nycresistor/TotU/README.md

TotU
====

Temple of the Unticketed

TotU
