nycresistor/TotU/Design/totu-sketch.png

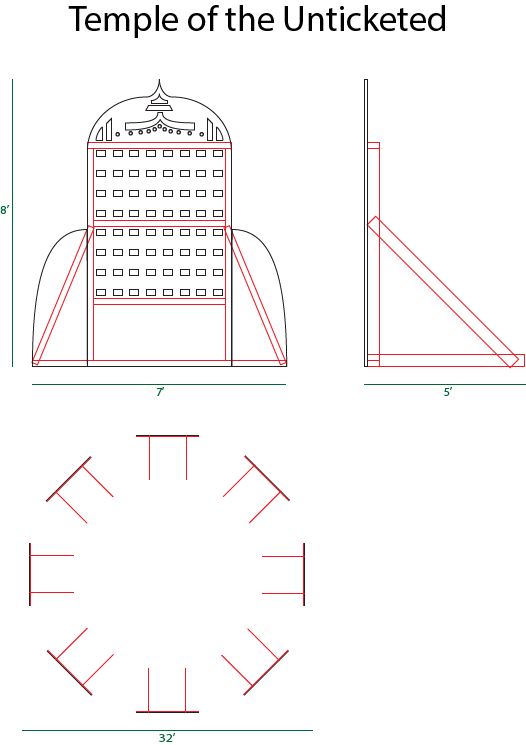
Design/totu-sketch.png
