nycresistor/TotU/Processing/TotU/data/0-PhotoBoothPhotoSmall.jpg

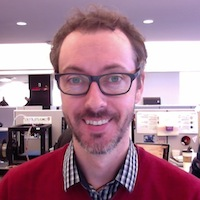
Processing/TotU/data/0-PhotoBoothPhotoSmall.jpg
