nycresistor/TotU/Processing/TotU/data/BMan11.jpg

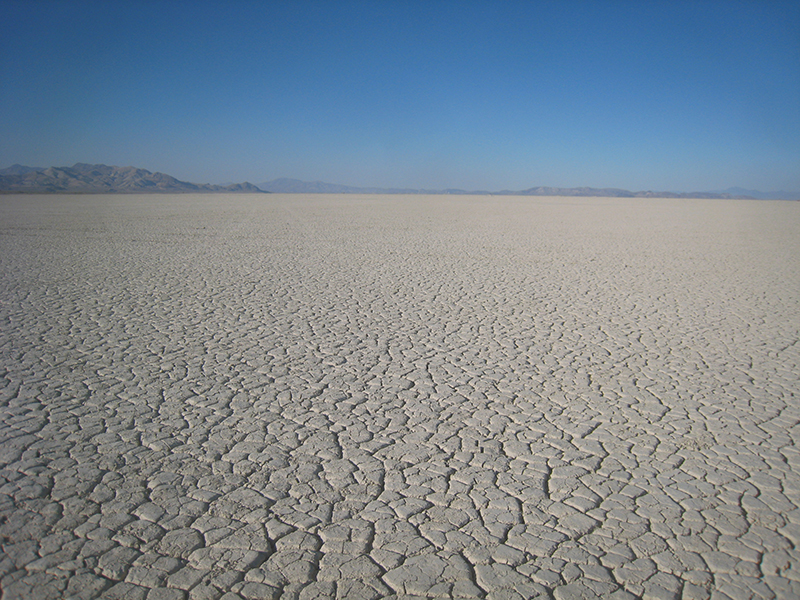
Processing/TotU/data/BMan11.jpg
