nycresistor/TotU/Logistics/TotU Budget.xlsx

Sheet: Budget
Temple of the Unticketed - Planning Budget
 |  |  | Tier 1 |  |  |  | Tier 2 |  |  |  | Tier 3
Line Item | Unit Cost | Redunancy | Per Panel | # Panels | Total | Cost | Per Panel | # Panels | Total | Cost | Per Panel | # Panels | Total | Cost
Cape
BBB | $55.00 | 50% | 4 | 8 | 48 | $2,640.00 | 2 | 8 | 24 | $1,320.00 | 2 | 6 | 18 | $990.00
Screens | $6.97 | 20% | 64 | 8 | 615 | $4,286.55 | 32 | 8 | 308 | $2,146.76 | 32 | 6 | 231 | $1,610.07
PCB (OSH Park) | $33.33 | 50% | 4 | 8 | 48 | $1,599.84 | 2 | 8 | 24 | $799.92 | 2 | 6 | 18 | $599.94
Assembly (Screaming) | $23.69 | 0% | 0 | 8 | 0 | $0.00 | 0 | 8 | 0 | $0.00 | 0 | 6 | 0 | $0.00
Components | $30.00 | 20% | 4 | 8 | 39 | $1,170.00 | 2 | 8 | 20 | $600.00 | 2 | 6 | 15 | $450.00
 |  |  |  |  |  |  |  |  | 0 |  |  |  | 0
TFT Adapter |  |  |  |  |  |  |  |  | 0 |  |  |  | 0
PCB (Sunstone) | $1.35 | 20% | 64 | 8 | 615 | $830.25 | 32 | 8 | 308 | $415.80 | 32 | 6 | 231 | $311.85
Assembly (Screaming) | $2.17 | 0% | 0 | 8 | 0 | $0.00 | 0 | 8 | 0 | $0.00 | 0 | 6 | 0 | $0.00
Components | $1.60 | 20% | 64 | 8 | 615 | $984.00 | 32 | 8 | 308 | $492.80 | 32 | 6 | 231 | $369.60
Power Module
PCB | $33.33 | 20% | 1 | 8 | 10 | $333.30 | 1 | 8 | 10 | $333.30 | 1 | 6 | 8 | $266.64
Assembly | $20.00 | 0% | 0 | 8 | 0 | $0.00 | 0 | 8 | 0 | $0.00 | 0 | 6 | 0 | $0.00
Components | $8.20 | 20% | 1 | 8 | 10 | $82.00 | 1 | 8 | 10 | $82.00 | 1 | 6 | 8 | $65.60
Networking
Switch | $100.00 | 20% | 1 | 8 | 10 | $1,000.00 | 1 | 8 | 10 | $1,000.00 | 1 | 6 | 8 | $800.00
BBB Master | $55.00 | 20% | 1 | 8 | 10 | $550.00 | 1 | 8 | 10 | $550.00 | 1 | 6 | 8 | $440.00
Cabling
25FT RJ45 | $11.28 | 5% | 2 | 8 | 17 | $191.76 | 2 | 8 | 17 | $191.76 | 2 | 6 | 13 | $146.64
2FT RJ45 | $0.75 | 5% | 64 | 8 | 538 | $403.50 | 32 | 8 | 269 | $201.75 | 32 | 6 | 202 | $151.50
Power
Batteries | $100.00 | 10% | 2 | 8 | 18 | $1,800.00 | 2 | 8 | 18 | $1,800.00 | 2 | 6 | 14 | $1,400.00
Chargers | $50.00 | 10% | 1 | 8 | 9 | $450.00 | 1 | 8 | 9 | $450.00 | 1 | 6 | 7 | $350.00
Hardware
Screws, etc. | $10.00 | 0% | 1 | 8 | 8 | $80.00 | 1 | 8 | 8 | $80.00 | 1 | 6 | 6 | $60.00
Wood | $20.00 | 0% | 1 | 8 | 8 | $160.00 | 1 | 8 | 8 | $160.00 | 1 | 6 | 6 | $120.00
Rebar, Sandbags | $20.00 | 0% | 1 | 8 | 8 | $160.00 | 1 | 8 | 8 | $160.00 | 1 | 6 | 6 | $120.00
Steel Pipe | $50.00 | 10% | 1 | 8 | 9 | $450.00 | 1 | 8 | 9 | $450.00 | 1 | 6 | 7 | $350.00
Fixed Costs |  |  |  |  |  | $17,171.20 |  |  |  | $11,234.09 |  |  |  | $8,601.84
Connectivity | $200.00
WiFi Equipment | $500.00
Gas/Electricity | $150.00
Container Space | $750.00
 | $1,600.00 |  |  |  | Total Tier 1 | $18,771.20 |  |  | Total Tier 2 | $12,834.09 |  |  | Total Tier 3 | $10,201.84

Sheet: Container Space
Assumptions | Panels |  |  | Base
Stackable panels | Width | 4 |  | Width | 10 | 2 x 10' pipes per base
Bases are stored as pipes+plywood | Height | 8 |  | Height | 4
 | Depth | 1 |  | Depth | 0.83
 |  | 32 |  |  | 33.2
 |  | 65.2 | cu ft
 |  | $489.00 | total
 |  | $733.50 | overbudget
