nycresistor/TotU/Design/lens.stl

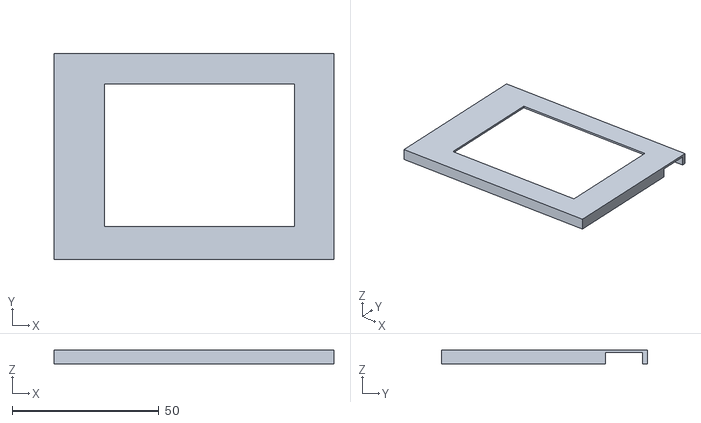
[picture p7: CAD file, 2015-05-30]
Design/lens.stl
95.5 x 70.2 x 4.80
