nycresistor/TotU/(threads)

Thread 6 (2014-12-31):

Mosfets are slightly too small to solder comfortably by hand

mhenstell, 2014-12-31:

Closed 2015-01-02.

Thread 11 (2015-01-03):

Mosfet symbol might have pins swapped

mhenstell, 2015-01-03:

Closed 2015-01-18.

Thread 18 (2015-02-03):

Fix or find better camera controls

potatono, 2015-02-03:

Thread 23 (2015-02-15):

Add caps to power/DC/reset lines on cape just for funsies

mhenstell, 2015-02-15:

Thread 24 (2015-02-15):

Replace power input connector with DC-DC board

mhenstell, 2015-02-15:

Thread 28 (2015-02-16):

TFT 0 backlight (pwm_0, gpio0_7) not working right

mhenstell, 2015-02-16:

mhenstell, 2015-02-17:
B 6th column off
A 1st col bottom out of phase??

mhenstell, 2015-02-18:
B6 seems to be an electrical issue, replace the mosfet and test again.
