nycresistor/TotU/Design/TotU.pdf

# Temple of the Unticketed

## Design Planning

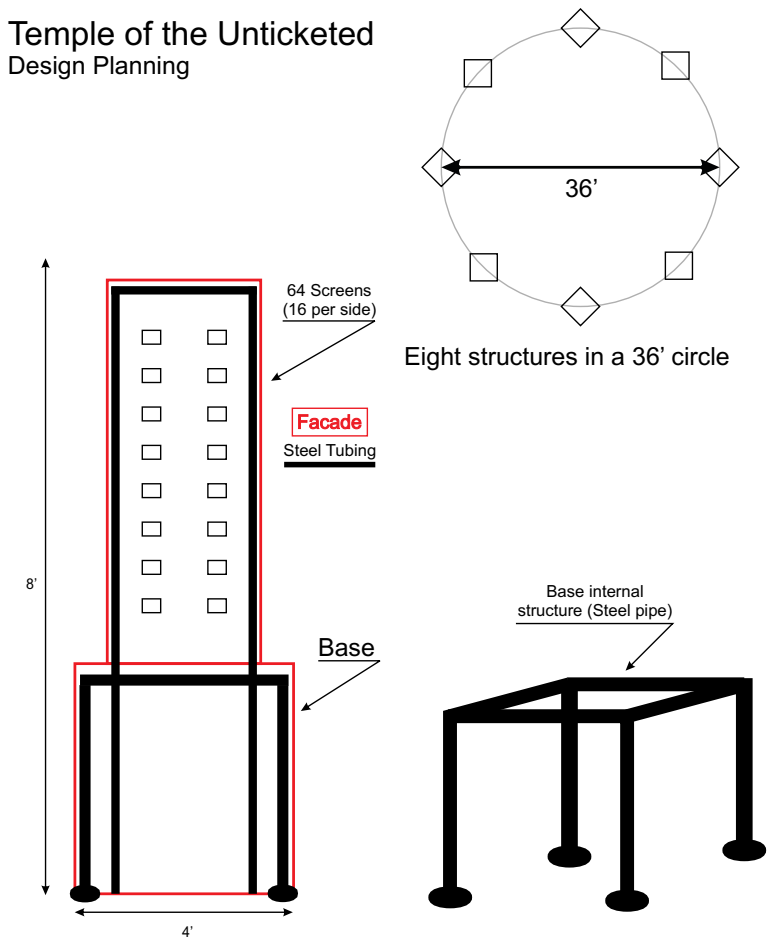
[picture p8: page 1]
Base; 64 Screens (16 per side); Facade; Steel Tubing

Eight structures in a 36’ circle

Base internal
structure (Steel pipe)
