nycresistor/TotU/Hardware/tft.brd

## EAGLE design Hardware/tft.brd (2015-01-20)

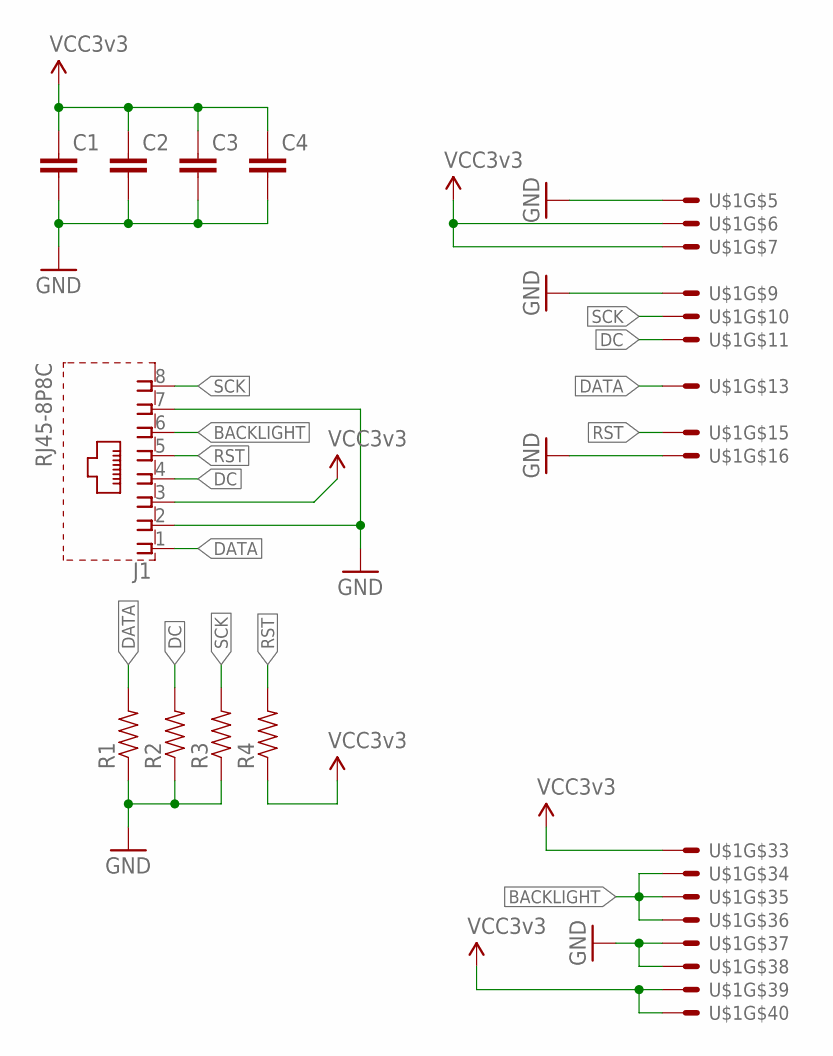
[picture p13: schematic tft.sch]

Parts:
C1, C2, C3, C4: CAP1206; 1206
J1: RJ45-8P8C; 54602-908LF; PARTNO 54602-908LF
R1, R2, R3, R4: RESISTOR0603; 0603-RES
U$1: XF2M-4015-WONKY

Connections:
BACKLIGHT: J1.6, U$1.34, U$1.35, U$1.36
DATA: J1.1, R1.2, U$1.13
DC: J1.4, R2.2, U$1.11
GND: C1.2, C2.2, C3.2, C4.2, J1.2, J1.7, R1.1, R2.1, R3.1, U$1.5, U$1.9, U$1.16, U$1.37, U$1.38
RST: J1.5, R4.2, U$1.15
SCK: J1.8, R3.2, U$1.10
VCC3V3: C1.1, C2.1, C3.1, C4.1, J1.3, R4.1, U$1.6, U$1.7, U$1.33, U$1.39, U$1.40

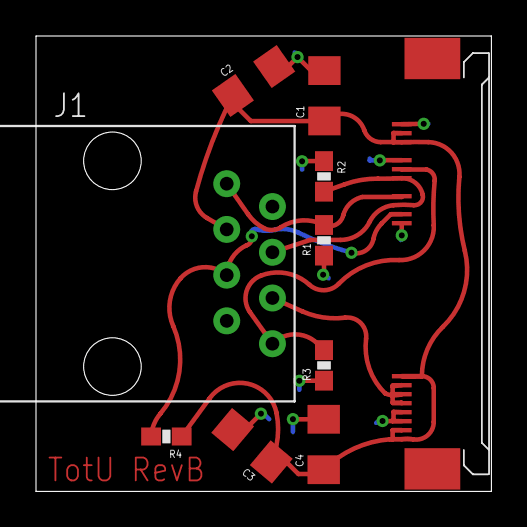
[picture p14: board tft.brd from above]

Board: 2 copper layers, 25.3 x 25.3 mm, 10 parts (0 on the bottom side), 7 nets.
