nycresistor/TotU/(commit log)

2014-09-16 added legs
    [TotU.scad]
2014-09-16 moved screens outward slightly
    [TotU.scad]
2014-09-16 added supports
    [TotU.scad]
2014-09-17 adding new layout
    [TotU2.scad]
2014-09-17 Housekeeping. Processing demo.
    [TotU.scad, TotU2.scad]
2014-09-17 made totems 3D, added legs
    [TotU2.scad]
2014-09-17 removing old Totu.scad
    [TotU.scad]
2014-09-18 added person to scale, changed radius, cleanup and comments
    [TotU2.scad]
2014-09-19 adding LCD frame
    [frame.scad]
2014-09-19 TotU2 includes frame scad
    [TotU2.scad]
2014-09-21 mostly working frame
    [frame.scad]
2014-09-22 added frame lens
    [frame.scad]
2014-09-22 cape init
    [cape.brd, cape.sch]
2014-09-23 fixed crashing issue
    [TotU2.scad]
2014-09-23 centering the viewable window
    [frame.scad]
2014-09-23 added circuits to control backlights, but I'm going to pull them out for this revision
    [cape.brd, cape.sch]
2014-09-23 removed led drivers, added backlight resistors
    [cape.brd, cape.sch]
2014-09-23 adding draft pin map
2014-09-24 tweaking dimensions
    [frame.scad]
2014-09-24 routing and pinmapping
    [cape.brd, cape.sch]
2014-10-01 mapping L3 memory manually seems to be working between arm and pru
2014-10-04 adding gpmc to spi test
2014-10-05 now with 100% less compiler errors
    [gpmc.c, gpmc.h, tft.c, tft.h]
2014-12-10 Down to 25.7 secs per frame
2014-12-13 Updated cape schematic and library, added datasheets
    [cape.brd, cape.sch]
2014-12-15 Working on board routing
    [cape.brd, cape.sch]
2014-12-17 Finished v1 board
    [cape.brd, cape.sch]
2014-12-17 added bird and fixed dimensions
    [cape.brd]
2014-12-18 adding tft pcb
    [tft.brd, tft.sch]
2014-12-21 Fixing variable name, cleanup
    [tft.c, tft.h, totu.c]
2014-12-21 Adding modified pario that handles PWM
2014-12-21 Bank switching should work now
2014-12-27 Working 16 channel PWM
2015-01-02 Added resistors (resolves #3), changed mosfet package (resolves #6), changed power input
    [cape.brd, cape.sch]
2015-01-10 Started adding A/B switches and more ports
    [cape.brd, cape.sch]
2015-01-11 Work on routing A/B and mosfets
    [cape.brd, cape.sch]
2015-01-12 More routing
    [cape.brd, cape.sch]
2015-01-15 Ripped up, starting over with new buffers
    [cape.brd, cape.sch]
2015-01-16 Buffer all the things
    [cape.brd, cape.sch]
2015-01-16 Adding gpmc device tree flags
2015-01-18 so much routing
    [cape.brd, cape.sch]
2015-01-18 Done routing
    [cape.brd, cape.sch]
2015-01-19 Rev B done
    [cape.brd, cape.sch]
2015-01-19 Oops, adding resistors
    [cape.brd, cape.sch]
2015-01-19 Updated year
    [cape.brd]
2015-01-20 Finished new tft board
    [tft.brd, tft.sch]
2015-01-20 Added solder mask to tft vias
    [tft.brd]
2015-01-21 Updating bom info
    [cape.brd, cape.sch]
2015-02-06 Budget and Plan
    [TotU Budget.xlsx, TotU Project Plan.xlsx]
2015-02-14 Updating backlight device tree overlay
2015-02-16 Working backlights 1-7 (0 not working right)
    [backlight.py]
2015-02-22 Separated MUX_S0 from MUX_S1 (fixes #30
    [cape-c.brd, cape-c.sch]
2015-02-22 Replaced 5v rail with 3.3v rail (fixes #13)
    [cape-c.brd, cape-c.sch]
2015-04-24 Added presliced mode, its got problems but is significantly slower due to network overhead. May be improved with direct ethernet connection. (WiFi->Eth was better than USB)
    [server.c]
2015-04-24 fixed preslice, faster over ethernet
    [server.c]
